PrathamBumb/555-Based-DC-DC-Boost-Converter/README.md

# 555-Based-DC-DC-Boost-Converter
During Sem 3 We have mini project So we Created 555 Based DC-DC Boost Converter
