PrathamBumb/555-Based-DC-DC-Boost-Converter/Schematic.png

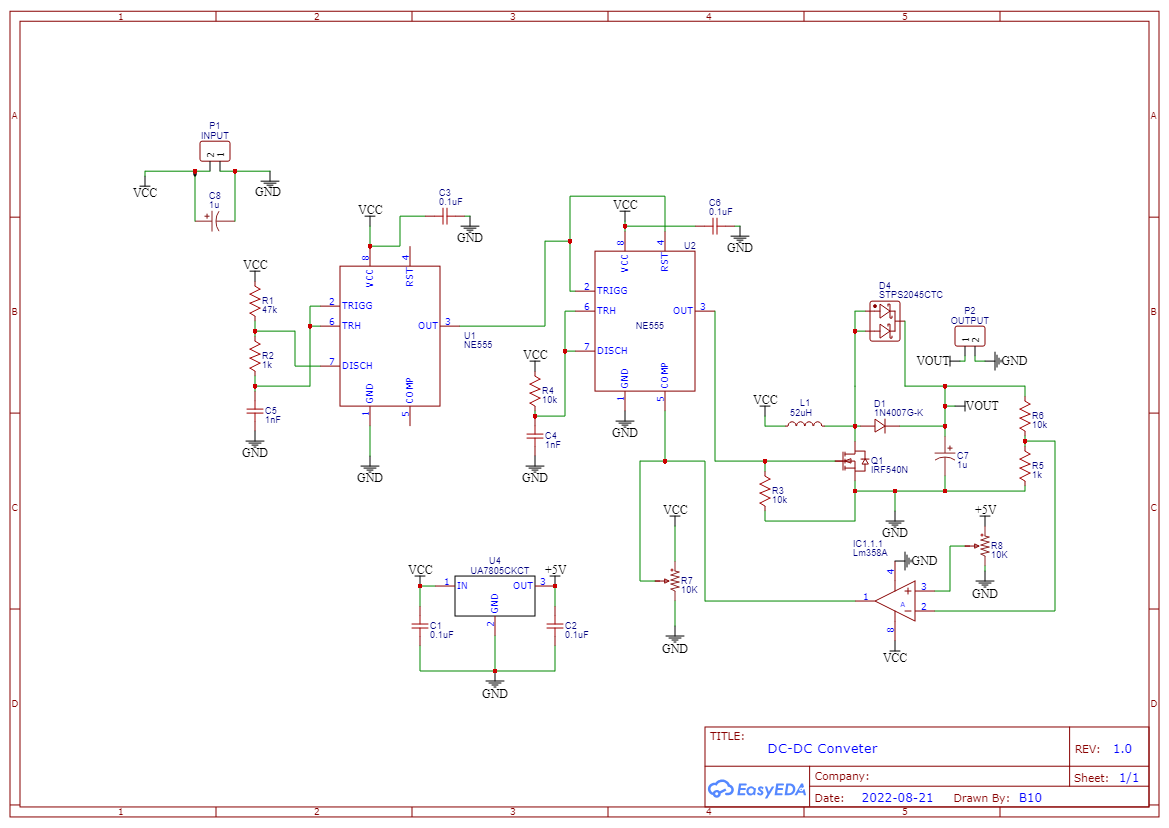
Schematic.png
