PrathamBumb/555-Based-DC-DC-Boost-Converter/(list of files, drawings)

Other design files:
miniProjectB10.pdsprj
